AIMS20/Caritas_DistanceMeter/Dimensions_Container.txt

CARITAS CONTAINER
AUSSEN:
     TIEFE: 114
     HÖHE: 208
     BREITE: 114,5

INNEN:
    TIEFE: 113
    HÖHE BIS KLAPPE HINTEN: 150
    HÖHE BIS TÜR VORNE: 130

HORIZONTALE MIT SCHRAUBE:
     TIEFE: 28
      BREITE: 102
      HÖHE BIS DAHIN: 130

SCHRAUBENVERSATZ (MITTE SCHRAUBE):
    SEITE: 6
    TIEFE: 3

SCHRAUBENDURCHMESSER: 7MM

------
ABSTAND BODEN >> LÖCHER SOLLTE 170cm SEIN!
------
LÖCHER MITTE OBEN: 5mm 
     ABSTAND DZW: 12,5
     PLATZ: 4
    ca 100° IN DIE MITTE

LÖCHER SEITE:
     ABSTAND DZW: 2,5
ca 105°
     PLATZ: 7

ANTENNE: 
CA 1m KABEL WENN MITTE OBEN
CA 2m40 WENN MITTE HINTEN
