AIMS20/Caritas_DistanceMeter/(commit log)

2020-12-14 reworked return-condition to accept negative values
    [HCSR04.cpp]
2021-01-05 added requirements (libraries, board manager)
2021-01-05 added Todos, sim pin for testing
2021-01-07 updated for esp32:
    -Replaced magic number with pauseMeasurement
    -Updated baud-rate
    -Added pinMode
    -Added debug output
    [SR04_UltrasonicSensor.ino]
2021-01-07 implemented SR04 sensor:
    -Added HCSR04, QuickMedianLib libraries
2021-01-07 implemented Blynk connection:
    -Added credentials
    -Added Blynk Library & functionality
    -Increased echoCount in hopes of less error readings
    -Removed deprecated code from tutorial
    -Added future Todos
    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
    [CDM_production_release.ino]
2021-01-12 fixed modem unable to init, refactor
    -added bool to stay offline
    -added test for modem connection
    -updated debug outputs
    -added rounding of filllevel
    -added battery reading, sending
    -added Todos
    [CDM_production_release.ino]
2021-01-19 power management, deepsleep when error readings, updated Todos
    -Included various new libraries to:
    -disabled wifi
    -disabled bt
    -disabled ADC
    -reduced cpu frequency
    [CDM_production_release.ino]
2021-01-19 added battery volt as data to send
2021-01-19 fixed deepsleep not possible (app. int overflow)
    -decreased pauseMeasurement
    -added hibernation implementation
    [CDM_production_release.ino]
2021-01-24 fixed median not being assigned right
    -added return -1 if fillLevel out of range
    [CDM_production_release.ino]
2021-01-26 optimized output
    -fixed fillLevel -1
    -reduced pause between measurements
    -increased samples
    -reduced roundingMultiple
    [CDM_production_release.ino]
2021-02-03 field test preperation updates
    -updated mountingheight
    -reduced echoCount
    -reduced wait- delay after sending values
    -increased time to sleep to 5h
    -fixed time to sleep not being uint
    -fixed bug not sending values after modem restarts
    [CDM_production_release.ino]
2021-02-03 updated measurements with new mountingheight
2021-02-12 fixed deep sleep timing:
    -used unsingled long long (ULL) instead of unsigned long (UL)
    [CDM_production_release.ino]
2021-02-12 refactoring
    -moved battery measurement
    -updated todos
2021-03-04 added option to toggle HCSR04 power
    moved from 3.3v pin to pin 33
2026-05-31 add bill of materials
